TugasAkhirBintangHabibKhusna/TUGAS-AKHIR/images/poster-a3.png

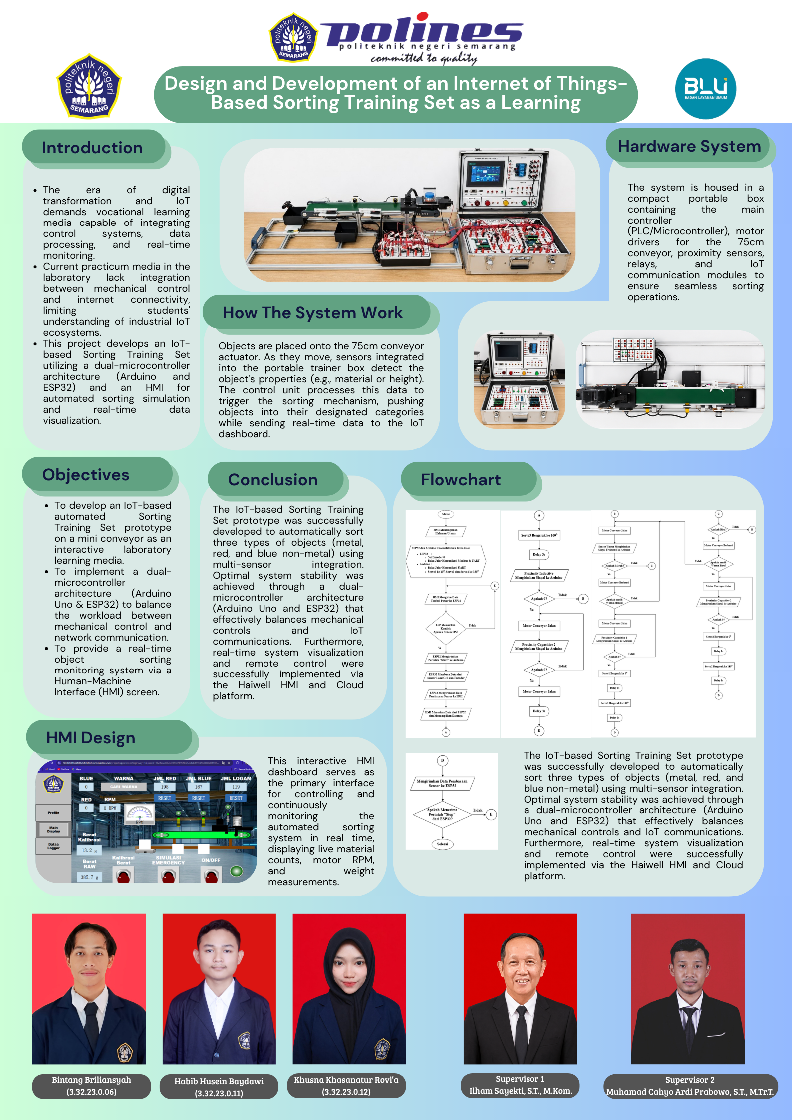
images/poster-a3.png
