TugasAkhirBintangHabibKhusna/TUGAS-AKHIR/images/background-industrial-subtle.jpg

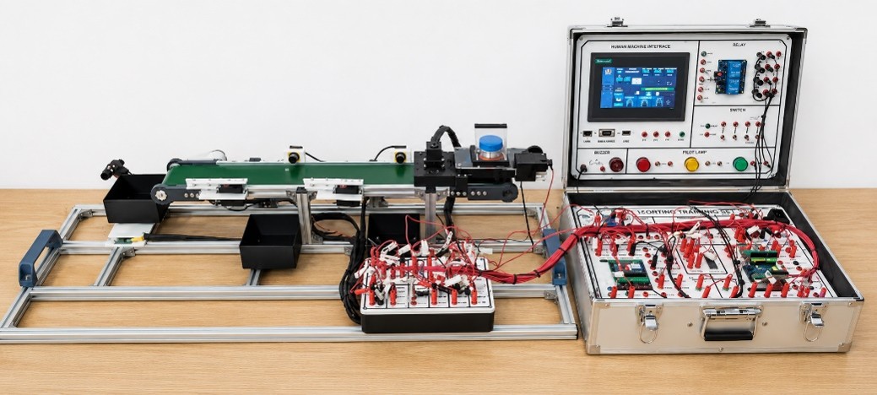
images/background-industrial-subtle.jpg
