TugasAkhirBintangHabibKhusna/TUGAS-AKHIR/images/foto-bintang.jpg

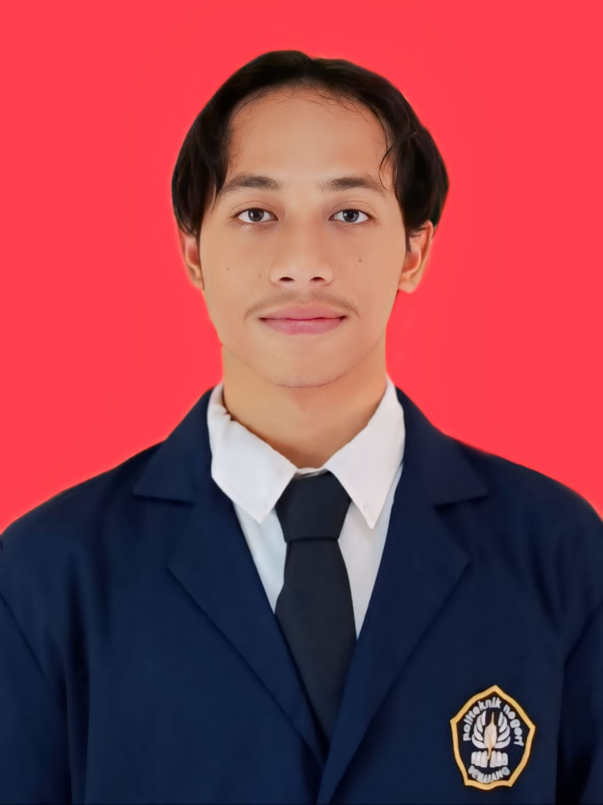
images/foto-bintang.jpg
