TugasAkhirBintangHabibKhusna/TUGAS-AKHIR/images/foto-habib.jpg

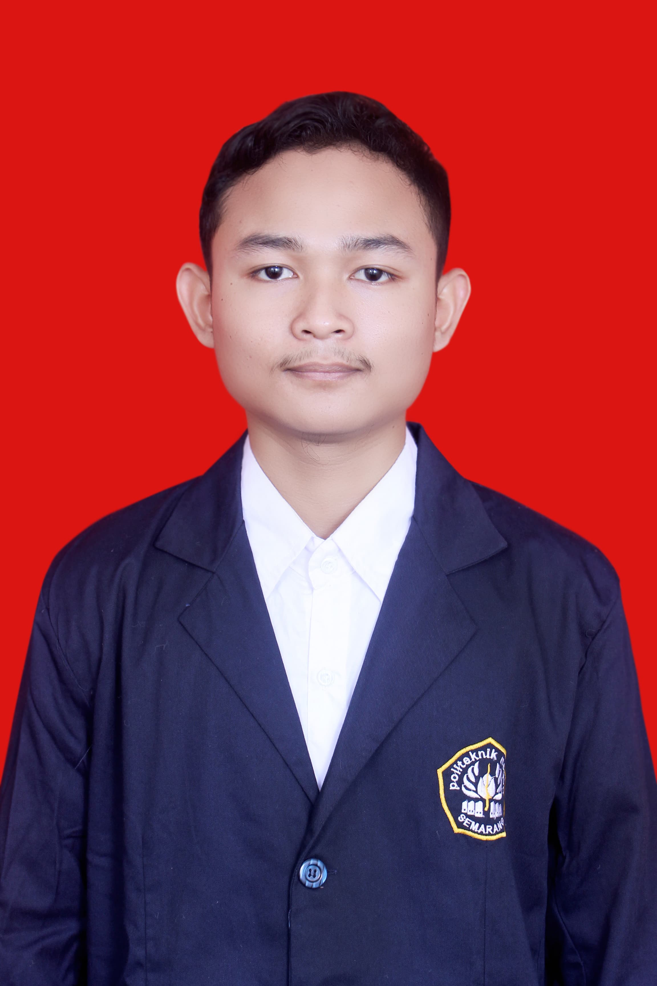
images/foto-habib.jpg
