TugasAkhirBintangHabibKhusna/TUGAS-AKHIR/images/foto-khusna.jpg

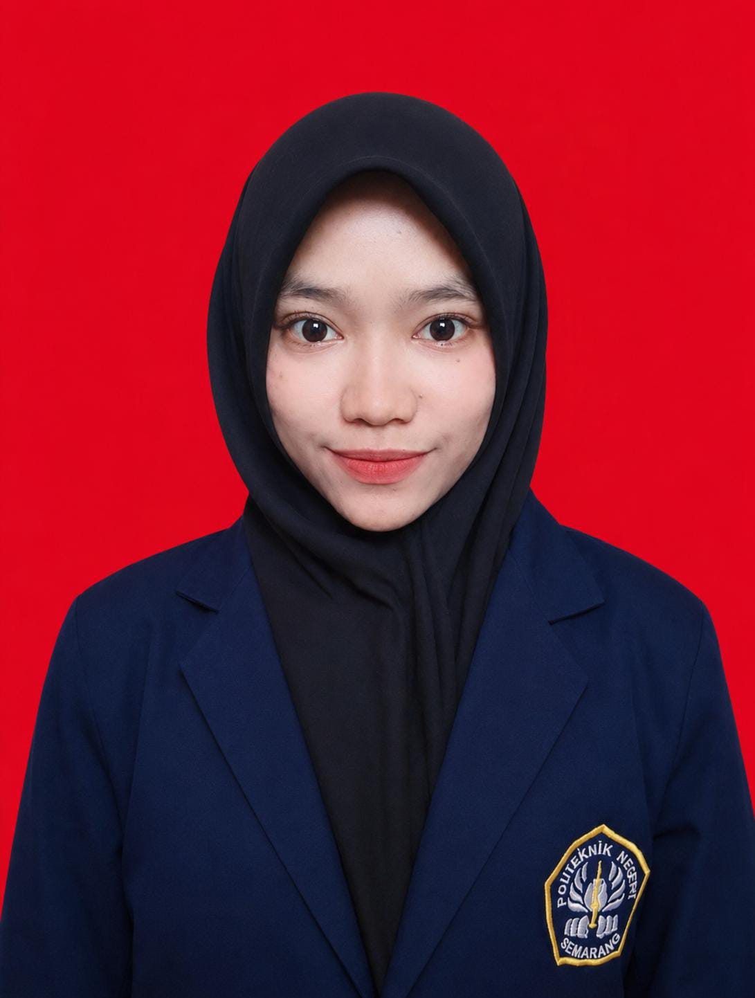
images/foto-khusna.jpg
