TugasAkhirBintangHabibKhusna/TUGAS-AKHIR/images/img-conveyor7.jpg

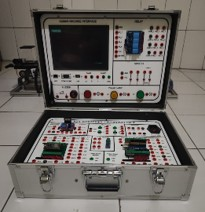
images/img-conveyor7.jpg
