TugasAkhirBintangHabibKhusna/TUGAS-AKHIR/images/img-hmi.jpg

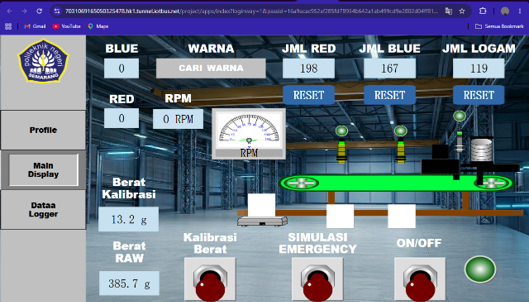
images/img-hmi.jpg
