TugasAkhirBintangHabibKhusna/TUGAS-AKHIR/images/img-rotary1.jpg

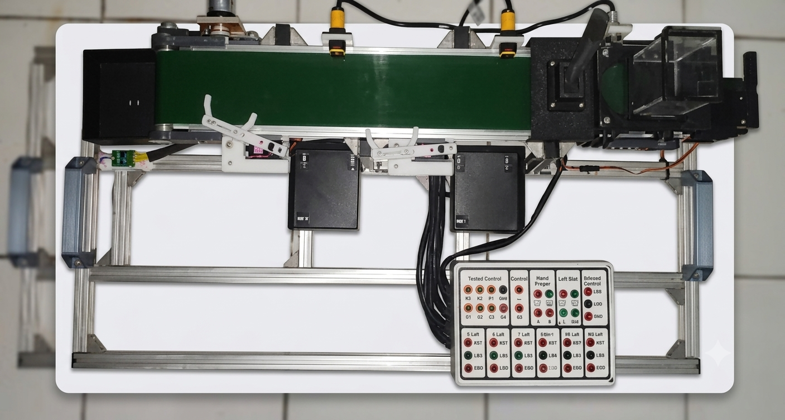
images/img-rotary1.jpg
