TugasAkhirBintangHabibKhusna/TUGAS-AKHIR/images/poster-a31.jpg

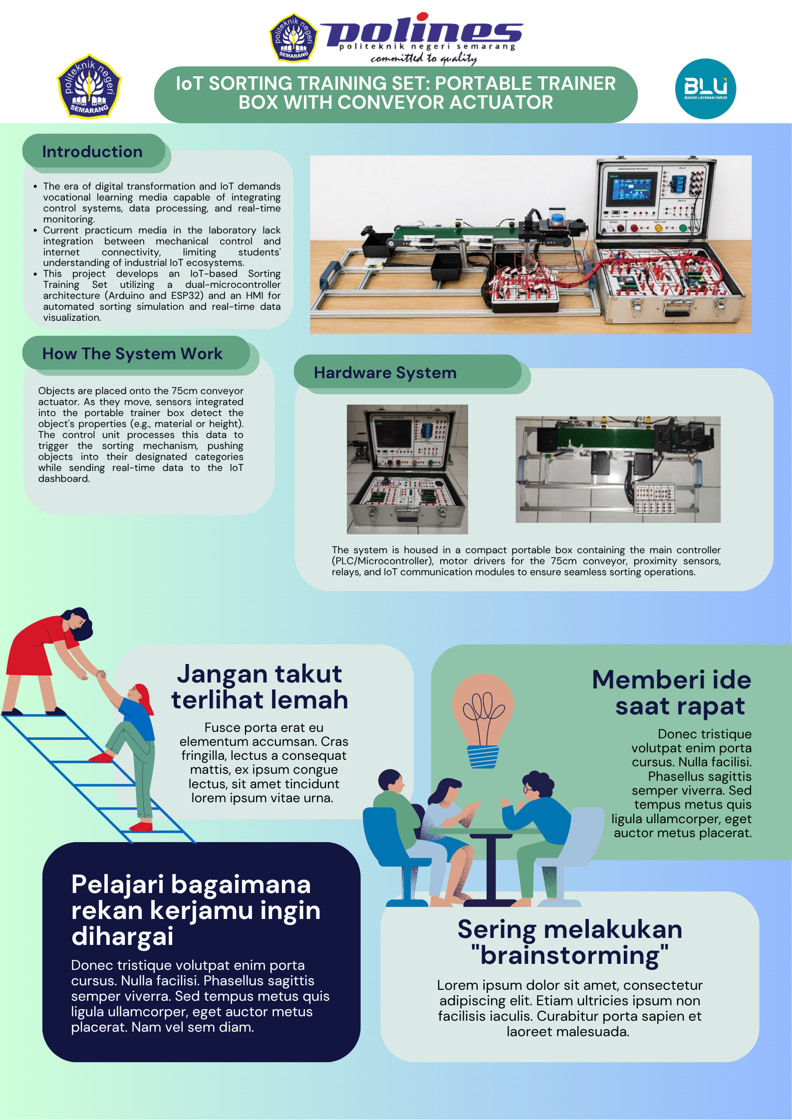
images/poster-a31.jpg
